judapies/Cabina-Flujo-Horizontal/2018/CFLH 120 Instruelectronic #004587854/SGC/FJP- 53 RECEPCION E INSPECCION DE PCB.docx

Fecha: | Referencia: | Modelo: | Orden de Pedido:

DESCRIPCIÓN DE LA MEDICIÓN | VALOR ESPERADO | VALOR OBTENIDO | OBSERVACIONES
Largo de PCB
Ancho de PCB
Pin 11 y Pin 12 U1 | Infinito
Pin 1 y Pin 2 LCD1 | Infinito
Tamaño Agujeros Sujeción | 5/32”
Pin 1 y Pin 2 J4 | Infinito
*Medición entre pines de Display | Infinito
Pin 1 y Pin 2 U7 | Infinito
Pin 1 y Pin 2 U5 | Infinito
Pin 1 y Pin 2 U4 | Infinito
Pin 3 y Pin 2 U4 | Infinito
Inspección Visual general de la PCB | N/A | N/A

OBSERVACIONES:____________________________________________________________________________________________________________________________________________________________________________________________________________________________________________________________________________________________________________________________________________________________________________________________

- Recuerde realizar las mediciones de acuerdo a la escala de la medida.
- Si fue necesario alguna corrección menciónela en la sección de observaciones y registre los valores medidos separados por un guion (-).

*Realizar la medición entre el pin 1 con todos los demás pines, de igual forma con los siguientes pines.

Realizo: | Revisó: | Aprobó:
Firma: | Firma: | Firma:
Cargo: | Cargo: | Cargo: Dirección Técnica
--------------------------------------------------- | --------------------------------------------------- | Estado de Calidad: Aprobado:_____ Rechazado:_____

JP BIOINGENIERIA S.A.S RECEPCIÓN E INSPECCIÓN DE PCB(BARE BOARD TEST) FJP – 53 Versión 01 Efectivo a partir de: Marzo 31 de 2018
