judapies/Cabina-Flujo-Horizontal/2016/Mini CFLH Cali/Materiales/Listado de Componentes Cabina de Flujo Laminar Horizontal.pdf

Cabina Flujo Vertical 110V
Descripción | Referencia
OptoTriac | MOC3031
Triac | BTA-16
Borneras | 2 Pines Verdes
| 3 Pines Verde
Conectores GP (con uñas) | 8 Pines
| 16 Pines
Fusible Corto | 500 mA maximo
Portafusible Aereo | Para fusible corto
Disipador | Mediano para 7805
Puente Rectificador | Redondo 1A
Regulador de Voltaje | LM7805
| LM7806
Reostato pequeño | 10K
Cristal de Cuarzo | 4MHz
Resistencias 1/4W | 10K
| 1K
| 330R
Resistencias de Presición | 1K
Condensador | 470uF/25V
| 10uF/16V
| 0.1uF Monolitico
| 22pF
| 0.1uF Tantalio superficial (CT1206 0.1UF35)
Display | 4X20
Transformador | 110V a 0-6-9V 450mA
Varistor | 20D241K
Microcontrolador | PIC 18F4550
Regleta Profesional | 40 pines
Poste plastico | Para sujecion de tarjeta
Tarjetas Electronicas | Control
Botones | Tipo huevo blanco
Sensor de Presión Diferencial | MPXV5400DP
Amplificador Operacional | LM324
Ingenieros Faiver H. Trujillo G | Juan David Piñeros E

Cantidad | Precio | Precio Total | Sitio de Compra | Dirección
6 | $ 2.552 | $ 15.312 Sigma Electronica Ltda | Av. Cra 24 No 61D-65
6 | $ 2.320 | $ 13.920 Sigma Electronica Ltda | Av. Cra 24 No 61D-65
1 | $ 350 | $ 350 Sanyvi Electronics | Cra 9 # 19-30 LOC:212
7 | $ 400 | $ 2.800 Sanyvi Electronics | Cra 9 # 19-30 LOC:212
1 | $ 400 | $ 400 Sanyvi Electronics | Cra 9 # 19-30 LOC:212
2 | $ 800 | $ 1.600 Sanyvi Electronics | Cra 9 # 19-30 LOC:212
1 | $ 100 | $ 100 Sanyvi Electronics | Cra 9 # 19-30 LOC:212
1 | $ 600 | $ 600 Sanyvi Electronics | Cra 9 # 19-30 LOC:212
1 | $ 2.000 | $ 2.000 Sanyvi Electronics | Cra 9 # 19-30 LOC:212
1 | $ 400 | $ 400 Sanyvi Electronics | Cra 9 # 19-30 LOC:212
1 | $ 550 | $ 550 Sanyvi Electronics | Cra 9 # 19-30 LOC:212
1 | $ 800 | $ 800 Sanyvi Electronics | Cra 9 # 19-30 LOC:212
1 | $ 300 | $ 300 Sanyvi Electronics | Cra 9 # 19-30 LOC:212
1 | $ 450 | $ 450 Sanyvi Electronics | Cra 9 # 19-30 LOC:212
6 | $ 10 | $ 60 Sanyvi Electronics | Cra 9 # 19-30 LOC:212
6 | $ 10 | $ 60 Sanyvi Electronics | Cra 9 # 19-30 LOC:212
6 | $ 10 | $ 60 Sanyvi Electronics | Cra 9 # 19-30 LOC:212
2 | $ 1.000 | $ 2.000 Electronica China | Calle 21 # 9-12
1 | $ 250 | $ 250 Sanyvi Electronics | Cra 9 # 19-30 LOC:212
3 | $ 150 | $ 450 Sanyvi Electronics | Cra 9 # 19-30 LOC:212
2 | $ 100 | $ 200 Sanyvi Electronics | Cra 9 # 19-30 LOC:212
2 | $ 100 | $ 200 Sanyvi Electronics | Cra 9 # 19-30 LOC:212
10 | $ 406 | $ 4.060 Sigma Electronica Ltda | Av. Cra 24 No 61D-65
1 | $ 25.000 | $ 25.000 Sanyvi Electronics | Cra 9 # 19-30 LOC:212
1 | $ 6.500 | $ 6.500 Sanyvi Electronics | Cra 9 # 19-30 LOC:212
2 | $ 2.000 | $ 4.000 Sanyvi Electronics | Cra 9 # 19-30 LOC:212
1 | $ 15.000 | $ 15.000 Sanyvi Electronics | Cra 9 # 19-30 LOC:212
3 | $ 1.200 | $ 3.600 Sanyvi Electronics | Cra 9 # 19-30 LOC:212
4 | $ 150 | $ 600 Sanyvi Electronics | Cra 9 # 19-30 LOC:212
1 | $ 17.000 | $ 17.000 Yahiko Electronica Ltda | Calle 20 # 8-89
4 | $ 1.800 | $ 7.200 ATM Store SAS | Cra 9 # 19-30 LOC: 117
1 | $ 46.400 | $ 46.400 Sigma Electronica Ltda | Av. Cra 24 No 61D-65
1 | $ 1.102 | $ 1.102 Sigma Electronica Ltda | Av. Cra 24 No 61D-65
$ 173.324 TOTAL

2014- Abr-15
