judapies/Cabina-Flujo-Horizontal/2016/CFLH 120 Alcaldia Guacheta #004587557/Materiales/Listado de Componentes Cabina de Flujo Laminar Horizontal.xlsx

Sheet: Parte Electronica 110V
 | Cabina Flujo Vertical 110V
 | Descripción | Referencia | Cantidad | Precio | Precio Total | Sitio de Compra | Dirección
 | OptoTriac | MOC3031 | 6 | $2552 | $15312 | Sigma Electronica Ltda | Av. Cra 24 No 61D-65
 | Triac | BTA-16 | 6 | $2320 | $13920 | Sigma Electronica Ltda | Av. Cra 24 No 61D-65
 | Borneras | 2 Pines Verdes | 1 | $350 | $350 | Sanyvi Electronics | Cra 9 # 19-30 LOC:212
 |  | 3 Pines Verde | 7 | $400 | $2800 | Sanyvi Electronics | Cra 9 # 19-30 LOC:212
 | Conectores GP (con uñas) | 8 Pines | 1 | $400 | $400 | Sanyvi Electronics | Cra 9 # 19-30 LOC:212
 |  | 16 Pines | 2 | $800 | $1600 | Sanyvi Electronics | Cra 9 # 19-30 LOC:212
 | Fusible Corto | 500 mA maximo | 1 | $100 | $100 | Sanyvi Electronics | Cra 9 # 19-30 LOC:212
 | Portafusible Aereo | Para fusible corto | 1 | $600 | $600 | Sanyvi Electronics | Cra 9 # 19-30 LOC:212
 | Disipador | Mediano para 7805 | 1 | $2000 | $2000 | Sanyvi Electronics | Cra 9 # 19-30 LOC:212
 | Puente Rectificador | Redondo 1A | 1 | $400 | $400 | Sanyvi Electronics | Cra 9 # 19-30 LOC:212
 | Regulador de Voltaje | LM7805 | 1 | $550 | $550 | Sanyvi Electronics | Cra 9 # 19-30 LOC:212
 |  | LM7806 | 1 | $800 | $800 | Sanyvi Electronics | Cra 9 # 19-30 LOC:212
 | Reostato pequeño | 10K | 1 | $300 | $300 | Sanyvi Electronics | Cra 9 # 19-30 LOC:212
 | Cristal de Cuarzo | 4MHz | 1 | $450 | $450 | Sanyvi Electronics | Cra 9 # 19-30 LOC:212
 | Resistencias 1/4W | 10K | 6 | $10 | $60 | Sanyvi Electronics | Cra 9 # 19-30 LOC:212
 |  | 1K | 6 | $10 | $60 | Sanyvi Electronics | Cra 9 # 19-30 LOC:212
 |  | 330R | 6 | $10 | $60 | Sanyvi Electronics | Cra 9 # 19-30 LOC:212
 | Resistencias de Presición | 1K | 2 | $1000 | $2000 | Electronica China | Calle 21 # 9-12
 | Condensador | 470uF/25V | 1 | $250 | $250 | Sanyvi Electronics | Cra 9 # 19-30 LOC:212
 |  | 10uF/16V | 3 | $150 | $450 | Sanyvi Electronics | Cra 9 # 19-30 LOC:212
 |  | 0.1uF Monolitico | 2 | $100 | $200 | Sanyvi Electronics | Cra 9 # 19-30 LOC:212
 |  | 22pF | 2 | $100 | $200 | Sanyvi Electronics | Cra 9 # 19-30 LOC:212
 |  | 0.1uF Tantalio superficial (CT1206 0.1UF35) | 10 | $406 | $4060 | Sigma Electronica Ltda | Av. Cra 24 No 61D-65
 | Display | 4X20 | 1 | $25000 | $25000 | Sanyvi Electronics | Cra 9 # 19-30 LOC:212
 | Transformador | 110V a 0-6-9V 450mA | 1 | $6500 | $6500 | Sanyvi Electronics | Cra 9 # 19-30 LOC:212
 | Varistor | 20D241K | 2 | $2000 | $4000 | Sanyvi Electronics | Cra 9 # 19-30 LOC:212
 | Microcontrolador | PIC 18F4550 | 1 | $15000 | $15000 | Sanyvi Electronics | Cra 9 # 19-30 LOC:212
 | Regleta Profesional | 40 pines | 3 | $1200 | $3600 | Sanyvi Electronics | Cra 9 # 19-30 LOC:212
 | Poste plastico | Para sujecion de tarjeta | 4 | $150 | $600 | Sanyvi Electronics | Cra 9 # 19-30 LOC:212
 | Tarjetas Electronicas | Control | 1 | $17000 | $17000 | Yahiko Electronica Ltda | Calle 20 # 8-89
 | Botones | Tipo huevo blanco | 4 | $1800 | $7200 | ATM Store SAS | Cra 9 # 19-30 LOC: 117
 | Sensor de Presión Diferencial | MPXV5400DP | 1 | $46400 | $46400 | Sigma Electronica Ltda | Av. Cra 24 No 61D-65
 | Amplificador Operacional | LM324 | 1 | $1102 | $1102 | Sigma Electronica Ltda | Av. Cra 24 No 61D-65
 |  |  |  |  | $173324 | TOTAL
Ingenieros | Faiver H. Trujillo G | Juan David Piñeros E | 2014- Abr-15

Sheet: Parte Electrica 110V
Cabina Flujo Horizontal 110V
Descripción | Referencia | Cantidad | Precio Unitario | Precio Total
Breaker CHINT 1 polo | 2A | 1 | $10000 | $10000
Interruptor de balancin redondo | 20mm Negro | 1 | $3000 | $3000
Regleta de polietileno | 30A | 1 | $4500 | $4500
Prensacable | PG11 | 4 | $800 | $3200
Cable Encauchetado Conalcables | 3X12 | 4 | $4500 | $18000
Clavija | 110V 15A Leviton | 1 | $6500 | $6500
Frenos | Para riel | 2 | $500 | $1000
 |  |  |  | $46200 | TOTAL

Sheet: Hoja1
 | Cabina Flujo Vertical 220V
 | Descripción | Referencia | Cantidad
 | OptoTriac | MOC3021 | 6
 | Triac | BT137 | 2
 |  | BTA-16 | 4
 | Borneras | 2 Pines Verdes | 7
 |  | 3 Pines Verde | 1
 | Conectores GP (con uñas) | 5 Pines | 1
 |  | 16 Pines | 2
 | Puente Rectificador | Redondo 1A | 1
 | Regulador de Voltaje | LM7805 | 1
 | Reostato | 10K | 1
 | Cristal de Cuarzo | 4MHz | 1
 | Resistencias 1/4W | 10K | 6
 |  | 1K | 6
 |  | 330R | 6
 | Condensador | 470uF/25V | 1
 |  | 10uF/16V | 3
 |  | 100nF (104) | 2
 |  | 22pF | 2
 | Display | 4X20 | 1
 | Microcontrolador | PIC 18F4550 | 1
 | Terminales | Según muestra | 8
 | Breaker CHINT 2 polos | 2A | 1
 | Breaker CHINT 1 polo | 10A | 1
 | Interruptor de balancin redondo | 20mm | 1
 | Toma doble blanca | Leviton | 1
 | Tapa de seguridad para toma doble | Plastica gris | 1
 | Regleta de polietileno | 15A | 1
 | Prensacable | PG11 | 4
 | Cable Encauchetado Conalcables | 4X12 | 3m
Ingenieros | Faiver H. Trujillo G | Juan David Piñeros E | 2014- Abr-15
