judapies/Cabina-Flujo-Horizontal/2018/CFLH 180 Flores de la Serena  #004587915/Materiales/Listado de Componentes Cabina de Bioseguridad.xlsx

Sheet: Parte Electronica 110V
Cabina Bioseguridad 110V
Descripción | Referencia | Cantidad | Sitio de Compra | Dirección
OptoTriac | MOC3041 | 4 | Sanyvi Electronics | Cra 9 # 19-30 LOC:212
Triac | BT-137 | 4 | Sanyvi Electronics | Cra 9 # 19-30 LOC:212
Borneras | 2 Pines Verdes | 12 | Sanyvi Electronics | Cra 9 # 19-30 LOC:212
Conectores GP (con uñas) | 8 Pines | 1 | Sanyvi Electronics | Cra 9 # 19-30 LOC:212
 | 3 Pines | 1 | Sanyvi Electronics | Cra 9 # 19-30 LOC:212
 | 2 Pines | 1 | Sanyvi Electronics | Cra 9 # 19-30 LOC:212
 | 4 Pines | 2 | Sanyvi Electronics | Cra 9 # 19-30 LOC:212
 | 16 Pines | 2 | Sanyvi Electronics | Cra 9 # 19-30 LOC:212
Disipador | Alto para 7805 | 1 | Sanyvi Electronics | Cra 9 # 19-30 LOC:212
Puente Rectificador | Redondo 1A | 1 | Sanyvi Electronics | Cra 9 # 19-30 LOC:212
Regulador de Voltaje | LM7805 | 1 | Sanyvi Electronics | Cra 9 # 19-30 LOC:212
Reostato pequeño | 10K | 1 | Sanyvi Electronics | Cra 9 # 19-30 LOC:212
Cristal de Cuarzo | 20MHz | 2 | Sanyvi Electronics | Cra 9 # 19-30 LOC:212
Resistencias 1/4W | 10K | 9 | Sanyvi Electronics | Cra 9 # 19-30 LOC:212
 | 1K | 7 | Sanyvi Electronics | Cra 9 # 19-30 LOC:212
 | 330R | 4 | Sanyvi Electronics | Cra 9 # 19-30 LOC:212
Condensador | 470uF/25V | 1 | Sanyvi Electronics | Cra 9 # 19-30 LOC:212
 | 10uF/16V | 1 | Sanyvi Electronics | Cra 9 # 19-30 LOC:212
 | 0.1uF Monolitico | 2 | Sanyvi Electronics | Cra 9 # 19-30 LOC:212
 | 15pF | 4 | Sanyvi Electronics | Cra 9 # 19-30 LOC:212
 | 0.1uF Tantalio superficial (CT1206 0.1UF35) | 10 | Sigma Electronica Ltda | Av. Cra 24 No 61D-65
Display Grafico Azul | 128X64 | 1 | Sigma Electronica Ltda | Av. Cra 24 No 61D-65
Fuente Conmutada | RS-15-12 | 1 | Sigma Electronica Ltda | Av. Cra 24 No 61D-65
Microcontrolador | PIC 18F4685 | 1 | Sanyvi Electronics | Cra 9 # 19-30 LOC:212
Regleta Profesional | 40 pines | 1 | Sanyvi Electronics | Cra 9 # 19-30 LOC:212
Poste plastico | Para sujecion de tarjeta | 4 | Sanyvi Electronics | Cra 9 # 19-30 LOC:212
Botones | Tipo huevo blanco | 4 | Sanyvi Electronics | Cra 9 # 19-30 LOC:212
Sensor de Presión Diferencial | MPXV5400DP | 2 | Sigma Electronica Ltda | Av. Cra 24 No 61D-65
Transistor | 2N3904 | 2 | Sanyvi Electronics | Cra 9 # 19-30 LOC:212
Diodo | 1N4004 | 2 | Sanyvi Electronics | Cra 9 # 19-30 LOC:212
Led | 5mm rojo | 1 | Sanyvi Electronics | Cra 9 # 19-30 LOC:212
Buzzer Redondo | Para Impreso 12V | 1 | Sanyvi Electronics | Cra 9 # 19-30 LOC:212
Conector Microfono | 2 Pines Metalico H-M | 5 | Sanyvi Electronics | Cra 9 # 19-30 LOC:212
 | 5 Pines Metalico H-M | 2 | Sanyvi Electronics | Cra 9 # 19-30 LOC:212
Pulsador | Normalmente Abierto negro | 1 | Sanyvi Electronics | Cra 9 # 19-30 LOC:212
Led | 5mm Rojo | 1 | Sanyvi Electronics | Cra 9 # 19-30 LOC:212
Interruptor magnetico | Blanco | 2 Parejas | Sanyvi Electronics | Cra 9 # 19-30 LOC:212
Interruptor redondo 20mm | ON-OFF Negro sin piloto | 1 | Sanyvi Electronics | Cra 9 # 19-30 LOC:212

Sheet: Parte Electrica 110V
Cabina Bioseguridad
Descripción | Referencia | Cantidad
Breaker CHINT 1 polo | 4A | 2
 | 10A | 1
Interruptor de balancin redondo | 20mm Negro | 1
Regleta de polietileno | 30A | 1
 | 5A | 2
Prensacable | PG11 | 4
 | PG13.5 | 4
Cable Encauchetado Centelsa | 3X12 | 5m
Clavija | 110V 15A Leviton | 1
Frenos | Para riel | 2
Contactor | Bobina 110V; 9A | 1
 | Bobina 110V; 18A | 1
Buzzer | 110V | 1

Sheet: Hoja1
 | Cabina Flujo Vertical 220V
 | Descripción | Referencia | Cantidad
 | OptoTriac | MOC3021 | 6
 | Triac | BT137 | 2
 |  | BTA-16 | 4
 | Borneras | 2 Pines Verdes | 7
 |  | 3 Pines Verde | 1
 | Conectores GP (con uñas) | 5 Pines | 1
 |  | 16 Pines | 2
 | Puente Rectificador | Redondo 1A | 1
 | Regulador de Voltaje | LM7805 | 1
 | Reostato | 10K | 1
 | Cristal de Cuarzo | 4MHz | 1
 | Resistencias 1/4W | 10K | 6
 |  | 1K | 6
 |  | 330R | 6
 | Condensador | 470uF/25V | 1
 |  | 10uF/16V | 3
 |  | 100nF (104) | 2
 |  | 22pF | 2
 | Display | 4X20 | 1
 | Microcontrolador | PIC 18F4550 | 1
 | Terminales | Según muestra | 8
 | Breaker CHINT 2 polos | 2A | 1
 | Breaker CHINT 1 polo | 10A | 1
 | Interruptor de balancin redondo | 20mm | 1
 | Toma doble blanca | Leviton | 1
 | Tapa de seguridad para toma doble | Plastica gris | 1
 | Regleta de polietileno | 15A | 1
 | Prensacable | PG11 | 4
 | Cable Encauchetado Conalcables | 4X12 | 3m
Ingenieros | Faiver H. Trujillo G | Juan David Piñeros E | 2014- Abr-15
