judapies/Cabina-Flujo-Horizontal/2019/CFLH 150 D4X20 San Pedro Valle #004588031 OP2019180/SGC/FJP- 35  REQUISICION DE MATERIALES CFLH-V LCD.xlsx

JP BIOINGENIERIA S.A.S |  |  | REQUISICION DE MATERIALES |  |  |  |  |  |  |  | FJP - 35
 |  |  |  |  |  |  |  |  |  |  | Version 01
Efectivo a partir de: 20 Dic 2017 |  |  |  |  |  | Documento de origen: DJP- 24 |  |  |  |  | Pág. 1 de 1
FECHA |  |  | 2019
PRODUCTO: | Cabina CFLH |  |  |  |  |  |  | Orden de Pedido No. |  |  | 2019180
 |  |  |  |  |  |  |  | Visita Técnica:
DESCRIPCION |  |  |  |  |  | Referencia |  |  | CANTIDAD REQUERIDA
Tarjeta de control |  |  |  |  |  | DIELEC-CFLH-V0016 |  |  | 1
Resistencias Montaje Superficial 0805 |  |  |  |  |  | 330Ω |  |  | 2
Resistencias Montaje Superficial 0805 |  |  |  |  |  | 10k |  |  | 6
Resistencias Montaje Superficial 0805 |  |  |  |  |  | 1k |  |  | 3
Resistencias (1W) |  |  |  |  |  | 15k |  |  | 2
Resistencias (1W) |  |  |  |  |  | 39Ω |  |  | 2
Resistencias (1W) |  |  |  |  |  | 360Ω |  |  | 2
Resistencias (1W) |  |  |  |  |  | 470Ω |  |  | 2
Condensador Electrolitico | Reóstato | Reóstato | Reóstato | Reóstato | Reóstato | 470uF/25V | 10K (pequeño) | 10K (pequeño) | 1 | 2 | 2 | 2
Condensador Electrolitico | Reóstato | Reóstato | Reóstato | Reóstato | Reóstato | 10uF/25V | 10K (pequeño) | 10K (pequeño) | 1 | 2 | 2 | 2
Condensador de Poliester | Reóstato | Reóstato | Reóstato | Reóstato | Reóstato | 103/600V | 10K (pequeño) | 10K (pequeño) | 2 | 2 | 2 | 2
Condensador de Poliester | Reóstato | Reóstato | Reóstato | Reóstato | Reóstato | 50nF/600V | 10K (pequeño) | 10K (pequeño) | 2 | 2 | 2 | 2
Condensador de tantalio SMD | Condensadores | Condensadores | Condensadores | Condensadores | Condensadores | 0,1uF | 10 µF @ 16V | 10 µF @ 16V | 2
Condensador Electrolitico SMD | Reóstato | Reóstato | Reóstato | Reóstato | Reóstato | 1uF/25V | 10K (pequeño) | 10K (pequeño) | 1 | 2 | 2 | 2
Condensador Ceramico | Condensadores | Condensadores | Condensadores | Condensadores | Condensadores | 22pF | 10 µF @ 16V | 10 µF @ 16V | 2
Cristal de Quarzo | Cristal | Cristal | Cristal | Cristal | Cristal | 4MHz | 4MHz | 4MHz | 1
Regleta Macho | Conector GP (Con uñas) | Conector GP (Con uñas) | Conector GP (Con uñas) | Conector GP (Con uñas) | Conector GP (Con uñas) | 1X40 | 2P | 2P | 1
Conector GP (Con uñas) | Conector GP (Con uñas) | Conector GP (Con uñas) | Conector GP (Con uñas) | Conector GP (Con uñas) | Conector GP (Con uñas) | 8P | 5P | 5P | 1
Regleta Hembra | Conector GP (Con uñas) | Conector GP (Con uñas) | Conector GP (Con uñas) | Conector GP (Con uñas) | Conector GP (Con uñas) | 1X40 | 5P | 5P | 1
Regleta profesional | Regleta profesional | Regleta profesional | Regleta profesional | Regleta profesional | Regleta profesional | 1X40 | 1X40 | 1X40 | 2
Optocoplador |  |  |  |  |  | MOC3021 |  |  | 2
Triac |  |  |  |  |  | BT139 |  |  | 2
Transistor Montaje Superficial |  |  |  |  |  | MMBT2222A |  |  | 1
Puente Rectificador Montaje Superficial |  |  |  |  |  | DF02S |  |  | 1
Fuente Conmutada para PCB | Puente Rectificador | Puente Rectificador | Puente Rectificador | Puente Rectificador | Puente Rectificador | HLK-PM05 | Redondo 1.5A | Redondo 1.5A | 1 | 2 | 2 | 2
Interruptor Redondo | Puente Rectificador | Puente Rectificador | Puente Rectificador | Puente Rectificador | Puente Rectificador | ON-OFF Negro | Redondo 1.5A | Redondo 1.5A | 1 | 2 | 2 | 2
Borneras | Bornera | Bornera | Bornera | Bornera | Bornera | 2 pines Verde | 2 pines Verde | 2 pines Verde | 6 | 2 | 2 | 2
Botones | Botones | Botones | Botones | Botones | Botones | Tipo huevo blanco | Tipo huevo blanco | Tipo huevo blanco | 4 | 6 | 6 | 6
Sensor de Presion | Botones | Botones | Botones | Botones | Botones | MPXV5004DP | Tipo huevo blanco | Tipo huevo blanco | 1 | 6 | 6 | 6
Buzzer | Buzzer | Buzzer | Buzzer | Buzzer | Buzzer | 5V ó 12V | 5V a 12V | 5V a 12V | 1 | 2 | 2 | 2
Diodo Montaje Superficial |  |  |  |  |  | FM4004 |  |  | 1
Led 0805 |  |  |  |  |  | Rojo o Verde o Azul |  |  | 1
Disipador con pines para soldar |  |  |  |  |  | Grande |  |  | 2
Reostato pequeño |  |  |  |  |  | 10k |  |  | 1
Portafusible para impreso |  |  |  |  |  | Con Tapa |  |  | 2
Fusible Corto |  |  |  |  |  | 4A |  |  | 2
Microcontrolador | Microcontrolador | Microcontrolador | Microcontrolador | Microcontrolador | Microcontrolador | PIC 18F4550 | PIC 18F4550 | PIC 18F4550 | 1 | 2 | 2 | 2
Display LCD | Microcontrolador | Microcontrolador | Microcontrolador | Microcontrolador | Microcontrolador | 4X20 Azul | PIC 18F4550 | PIC 18F4550 | 1 | 2 | 2 | 2
Switch Magnetico |  |  |  |  |  | Para posicion de Vidrio |  |  | 1
Iman para Switch Magnetico |  |  |  |  |  | Para posicion de Vidrio |  |  | 1
Optocoplador |  |  |  |  |  | PC817 |  |  | 1
Rele de Estado Solido para impreso |  |  |  |  |  | G3MB-202P |  |  | 2
Varistor |  |  |  |  |  | 20Dk241 |  |  | 1
Breaker unipolar CHINT 4A |  |  |  |  |  | 09606 |  |  | 1
Breaker unipolar CHINT 10A |  |  |  |  |  | 09610 |  |  | 1
Riel |  |  |  |  |  | Omega |  |  | 15cm
Frenos para riel omega |  |  |  |  |  |  |  |  | 2
Pasacable |  |  |  |  |  | PG11
Pasacable |  |  |  |  |  | PG13,5
Clavija Leviton Amarilla |  |  |  |  |  | 115VAC/15A |  |  | 1
Toma |  |  |  |  |  | Hidrobox |  |  | 1
Modulo |  |  |  |  |  | Hidrobox |  |  | 1
Terminal |  |  |  |  |  | Tipo Bala hembra (roja)
Terminal |  |  |  |  |  | Tipo Bala Macho(roja)
Terminal |  |  |  |  |  | Tipo Bala hembra (Azul)
Terminal |  |  |  |  |  | Tipo Bala Macho (Azul)
Terminal |  |  |  |  |  | Tipo ojo (Amarilla)
Terminal |  |  |  |  |  | Tipo Faston (Azul)
Bornera plastica |  |  |  |  |  | 15A
Luz led |  |  |  |  |  |  |  |  | 1
Luz UV Germicida |  |  |  |  |  | 30W |  |  | 1
Balastro Multivoltaje |  |  |  |  |  | 2X32W |  |  | 1
Cable (sensor flujo) |  |  |  |  |  | Blindado 6x22
Cable (sensor vidrio) |  |  |  |  |  | Blindado 6x22
Cable (Botones) |  |  |  |  |  | Blindado 8x22
Cable (toma) |  |  |  |  |  | Encauchetado 3x14
Cable (Alimentacion) |  |  |  |  |  | Encauchetado 3x14
Cable (Motores) |  |  |  |  |  | Encauchetado 3x18
Cable (Luz blanca) |  |  |  |  |  | Encauchetado 2x18
Cable (Luz UV) |  |  |  |  |  | Encauchetado 2x18
SOLICITADO POR: |  |  |  | ENTREGADO POR: |  |  |  | RECIBIDO POR:
