judapies/Cabina-Flujo-Horizontal/2019/CFLH 60 Asociados en Reproduccion Humana#004587947/SGC/FJP- 35  REQUISICION DE MATERIALES CABINA DE FLUJO HORIZONTAL GLCD.xlsx

JP BIOINGENIERIA S.A.S |  |  | REQUISICION DE MATERIALES |  |  |  |  |  |  |  | FJP - 35
 |  |  |  |  |  |  |  |  |  |  | Version 01
Efectivo a partir de: 20 Dic 2017 |  |  |  |  |  | Documento de origen: DJP- 24 |  |  |  |  | Pág. 1 de 1
FECHA | 14 | 3 | 2019
PRODUCTO: | CFLH 60 GLCD |  |  |  |  |  |  | Orden de Pedido No. |  |  | 201942
 |  |  |  |  |  |  |  | Visita Técnica:
DESCRIPCION |  |  |  |  |  | Referencia |  |  | CANTIDAD REQUERIDA
Tarjeta de control |  |  |  |  |  | CabinaBioseguridad |  |  | 1
Resistencia (1/4W) |  |  |  |  |  | 330Ω |  |  | 4
Resistencias (1/4W) |  |  |  |  |  | 10k |  |  | 8
Resistencias (1/4W) |  |  |  |  |  | 1k |  |  | 8
Resistencias (1W) |  |  |  |  |  | 1k |  |  | 1
Condensador de Poliester | Reóstato | Reóstato | Reóstato | Reóstato | Reóstato | 104/600V | 10K (pequeño) | 10K (pequeño) | 1 | 2 | 2 | 2
Condensador Electrolitico | Condensadores | Condensadores | Condensadores | Condensadores | Condensadores | 470 µF @ 16V | 470 µF @ 16V | 470 µF @ 16V | 1 | 2 | 2 | 2
Condensador Electrolitico | Condensadores | Condensadores | Condensadores | Condensadores | Condensadores | 10 µF @ 16V | 10 µF @ 16V | 10 µF @ 16V | 1
Condensador de tantalio SMD | Condensadores | Condensadores | Condensadores | Condensadores | Condensadores | 0,1uF | 10 µF @ 16V | 10 µF @ 16V | 3
Condensador Monolitico | Condensadores | Condensadores | Condensadores | Condensadores | Condensadores | 104 | 10 µF @ 16V | 10 µF @ 16V | 2
Condensador Ceramico | Condensadores | Condensadores | Condensadores | Condensadores | Condensadores | 22pF | 10 µF @ 16V | 10 µF @ 16V | 2
Cristal de Quarzo | Cristal | Cristal | Cristal | Cristal | Cristal | 20MHz | 4MHz | 4MHz | 1
Conector GP (Con uñas) | Conector GP (Con uñas) | Conector GP (Con uñas) | Conector GP (Con uñas) | Conector GP (Con uñas) | Conector GP (Con uñas) | 2P | 2P | 2P | 1
Conector GP (Con uñas) | Conector GP (Con uñas) | Conector GP (Con uñas) | Conector GP (Con uñas) | Conector GP (Con uñas) | Conector GP (Con uñas) | 8P | 5P | 5P | 1
Conector GP (Con uñas) | Conector GP (Con uñas) | Conector GP (Con uñas) | Conector GP (Con uñas) | Conector GP (Con uñas) | Conector GP (Con uñas) | 4P | 5P | 5P | 2
Conector GP (Con uñas) | Conector GP (Con uñas) | Conector GP (Con uñas) | Conector GP (Con uñas) | Conector GP (Con uñas) | Conector GP (Con uñas) | 16P | 5P | 5P | 2
Regleta profesional | Regleta profesional | Regleta profesional | Regleta profesional | Regleta profesional | Regleta profesional | 1X40 | 1X40 | 1X40 | 2
Optocoplador |  |  |  |  |  | MOC3041 |  |  | 4
Triac |  |  |  |  |  | BT137 |  |  | 4
Transistor |  |  |  |  |  | 2N3904 |  |  | 2
Puente Rectificador |  |  |  |  |  | Redondo 1.5A |  |  | 1
Regulador 5V | Regulador 5V | Regulador 5V | Regulador 5V | Regulador 5V | Regulador 5V | LM7805 | LM 7805 | LM 7805 | 1
Fuente Conmutada | Puente Rectificador | Puente Rectificador | Puente Rectificador | Puente Rectificador | Puente Rectificador | 12V - 1,3A RS-15-12 | Redondo 1.5A | Redondo 1.5A | 1 | 2 | 2 | 2
Interruptor Redondo | Puente Rectificador | Puente Rectificador | Puente Rectificador | Puente Rectificador | Puente Rectificador | ON-OFF Negro | Redondo 1.5A | Redondo 1.5A | 1 | 2 | 2 | 2
Borneras | Bornera | Bornera | Bornera | Bornera | Bornera | 2 pines Verde | 2 pines Verde | 2 pines Verde | 12 | 2 | 2 | 2
Botones | Botones | Botones | Botones | Botones | Botones | Tipo huevo blanco | Tipo huevo blanco | Tipo huevo blanco | 4 | 6 | 6 | 6
Buzzer | Buzzer | Buzzer | Buzzer | Buzzer | Buzzer | 5V ó 12V | 5V a 12V | 5V a 12V | 1 | 2 | 2 | 2
Diodo |  |  |  |  |  | 1N4004 |  |  | 1
Diodo led difuso |  |  |  |  |  | Rojo 5mm |  |  | 1
Disipador con pines para soldar |  |  |  |  |  | Mediano |  |  | 1
Reostato pequeño |  |  |  |  |  | 10k |  |  | 1
Sensor de presion |  |  |  |  |  | MPXV5004DP |  |  | 1
Microcontrolador | Microcontrolador | Microcontrolador | Microcontrolador | Microcontrolador | Microcontrolador | PIC 18F4685 | PIC 18F4550 | PIC 18F4550 | 1 | 2 | 2 | 2
Display GLCD | Microcontrolador | Microcontrolador | Microcontrolador | Microcontrolador | Microcontrolador | 128x64 px Azul | PIC 18F4550 | PIC 18F4550 | 1 | 2 | 2 | 2
Poste Plastico 18mm de altura |  |  |  |  |  | POSTE-18 (https://www.sigmaelectronica.net/producto/poste-18/) |  |  | 5
Breaker unipolar CHINT 10A |  |  |  |  |  | 09610 |  |  | 1
Riel |  |  |  |  |  | Omega
Frenos para riel omega |  |  |  |  |  |  |  |  | 2
Pasacable |  |  |  |  |  | PG11 |  |  | 5
Pasacable |  |  |  |  |  | PG13,5 |  |  | 2
Clavija Leviton Amarilla |  |  |  |  |  | 115VAC/15A |  |  | 1
Contactor CHINT 9A 110V |  |  |  |  |  | 00905 |  |  | 1
Balastro |  |  |  |  |  | 2X32W |  |  | 1
Caja de Paso Plastica |  |  |  |  |  | K2121-116 |  |  | 1
Luz LED Tipo Regleta |  |  |  |  |  | 60cm |  |  | 1
Interruptor de Codillo |  |  |  |  |  | 2 Posiciones |  |  | 1
Terminal |  |  |  |  |  | Tipo Bala hembra (roja)
Terminal |  |  |  |  |  | Tipo Bala Macho(roja)
Terminal |  |  |  |  |  | Tipo Bala hembra (Azul)
Terminal |  |  |  |  |  | Tipo Bala Macho (Azul)
Terminal |  |  |  |  |  | Tipo ojo (Amarilla)
Terminal |  |  |  |  |  | Tipo Faston (Azul)
Bornera plastica |  |  |  |  |  | 15A
Cable (Botones) |  |  |  |  |  | Blindado 8x22
Cable (Alimentacion) |  |  |  |  |  | Encauchetado 3x14
Cable (Motores) |  |  |  |  |  | Encauchetado 3x18
Cable (Luz blanca) |  |  |  |  |  | Encauchetado 2x18
Cable (Luz UV) |  |  |  |  |  | Encauchetado 2x18
SOLICITADO POR: |  |  |  | ENTREGADO POR: |  |  |  | RECIBIDO POR:
