judapies/Cabina-Flujo-Horizontal/2018/CFLH 120 Blamis Medidor de Flujo #004587820/Schematic con Seleccion de Velocidad/CabinaCFLH_SensorFlujo.DXF

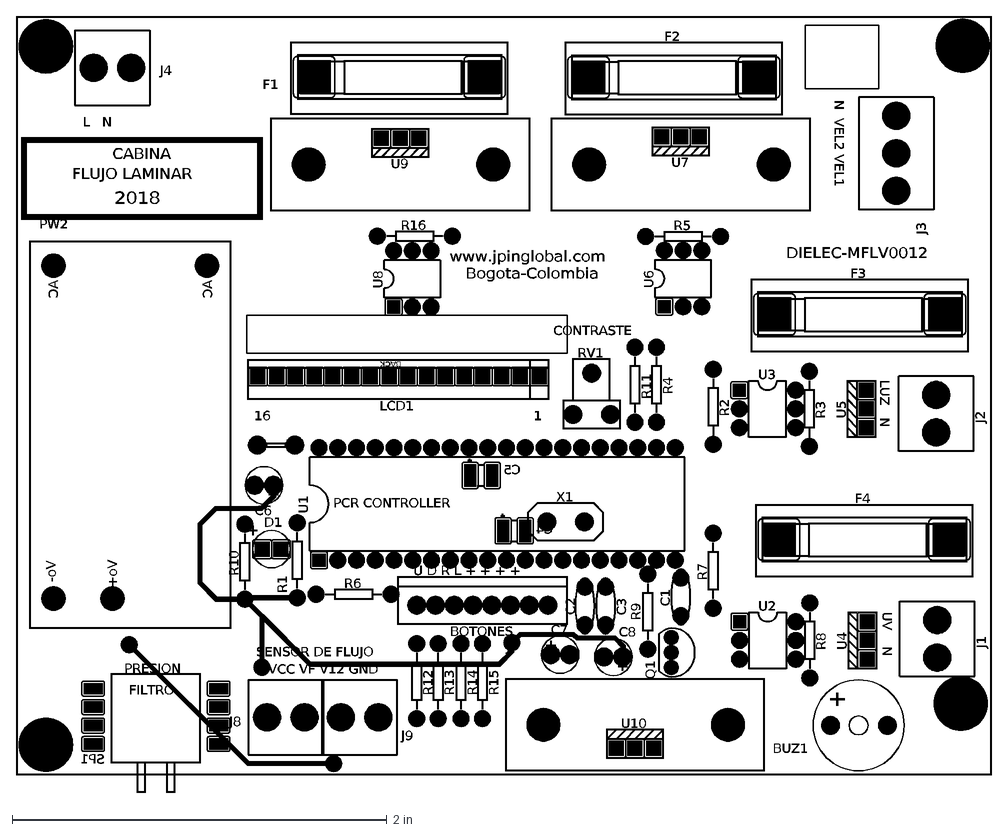
[picture p3: CAD file, 2021-07-15]
2018/CFLH 120 Blamis Medidor de Flujo #004587820/Schematic con Seleccion de Velocidad/CabinaCFLH_SensorFlujo.DXF
U1
J7
R12
R13
R14
R15
R6
SP1
R1
C1
BACK
LCD1
RV1
X1
C2
C3
J4
R7
R2
R3
R4
U2
U3
U6
R8
R5
U4
U5
U7
J1
J2
F1
CABINA
FLUJO LAMINAR
2018
C4
C5
C6
AC
Vo+
Vo-
PW2
PCR CONTROLLER
BOTONES
U D R L + + + +
PRESION
FILTRO
1
16
CONTRASTE
L N
N VEL2 VEL1
UV N
LUZ N
+
BUZ1
Q1
R9
D1
R10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
