judapies/Cabina-Flujo-Horizontal/2018/CFLH 180 Flores de la Serena  #004587915/Schematic/CabinaBioseguridad.DXF

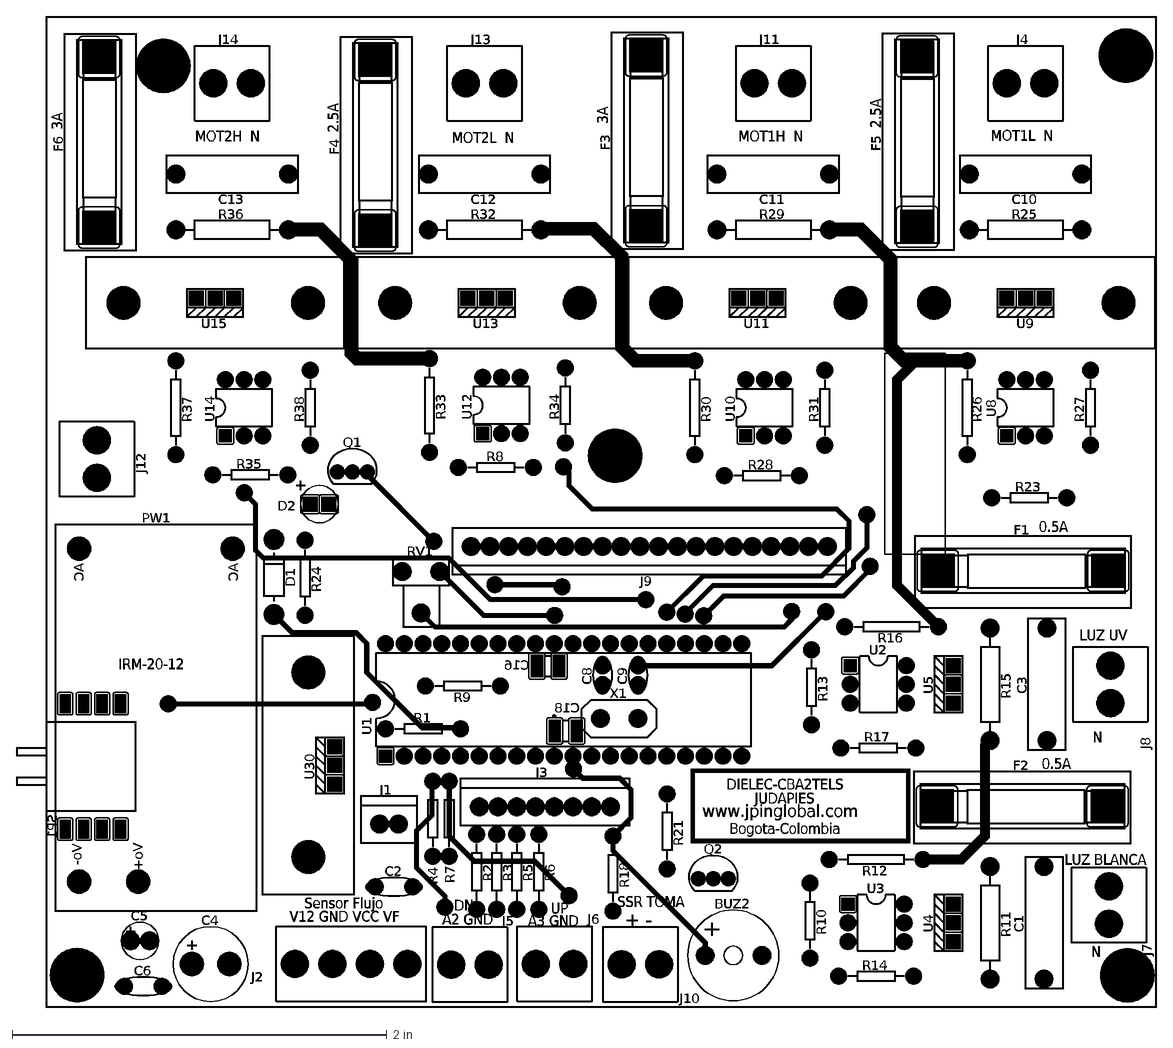
[picture p4: CAD file, 2021-07-15]
2018/CFLH 180 Flores de la Serena #004587915/Schematic/CabinaBioseguridad.DXF
U1
AC
Vo+
Vo-
PW1
C4
C5
C6
U30
D1
J2
J3
R2
R3
R4
R5
R6
R7
J5
J6
R24
D2
R18
J10
R21
Q2
+
BUZ2
J9
SP1
C2
J1
R1
R10
U3
R12
R14
U4
R11
C1
F2
J7
R13
U2
R16
R17
U5
R15
C3
J8
F1
R23
U8
R26
R27
U9
R25
C10
J4
F5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
