judapies/Cabina-Flujo-Horizontal/2019/CFLH 150 D4X20 San Pedro Valle #004588031 OP2019180/Schematic/User Library-LCD 4X20.IGS

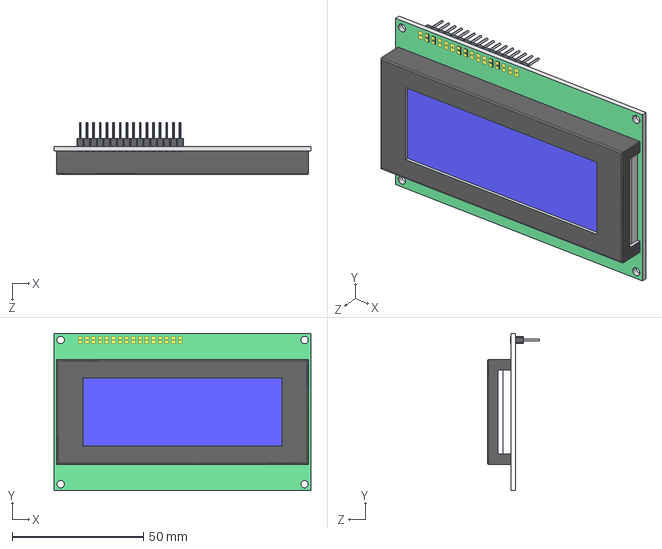
[picture p5: CAD file, 2021-07-15]
2019/CFLH 150 D4X20 San Pedro Valle #004588031 OP2019180/Schematic/User Library-LCD 4X20.IGS
98.0 x 60.0 x 20.0 mm
