judapies/Cabina-Flujo-Horizontal/2019/CFLH 60 TIM #004587995 OP2019135/Schematic/CabinaCFLH-V-D4X20.DXF

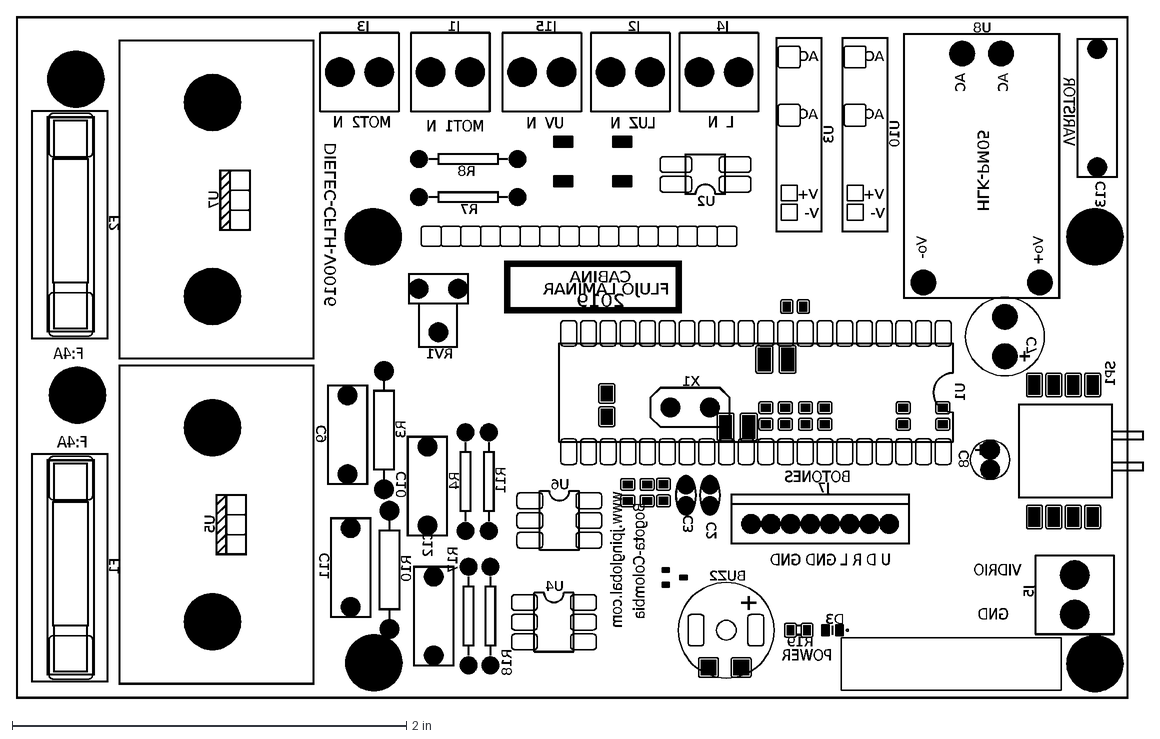
[picture p7: CAD file, 2021-07-15]
2019/CFLH 60 TIM #004587995 OP2019135/Schematic/CabinaCFLH-V-D4X20.DXF
CABINA
FLUJO LAMINAR
2019
Bogota-Colombia
www.jpinglobal.com
HLK-PM05
U1
SP1
D3
R19
C2
C3
X1
J5
J4
R7
R8
U2
U4
R17
R18
U5
C12
R10
C11
F1
U6
R4
R11
C10
R3
C9
U7
F2
J1
J3
J7
+
BUZ2
RV1
AC
V+
V-
U3
U10
Vo+
Vo-
U8
J2
J15
C13
C7
C8
L N
LUZ N
UV N
MOT1 N
MOT2 N
F:4A
VARISTOR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
