judapies/Cabina-Flujo-Horizontal/2019/CFLH 90 D4x20 Biomerk #004587991 OP2019126/Schematic con Seleccion de Velocidad/CabinaCFLH-V.DXF

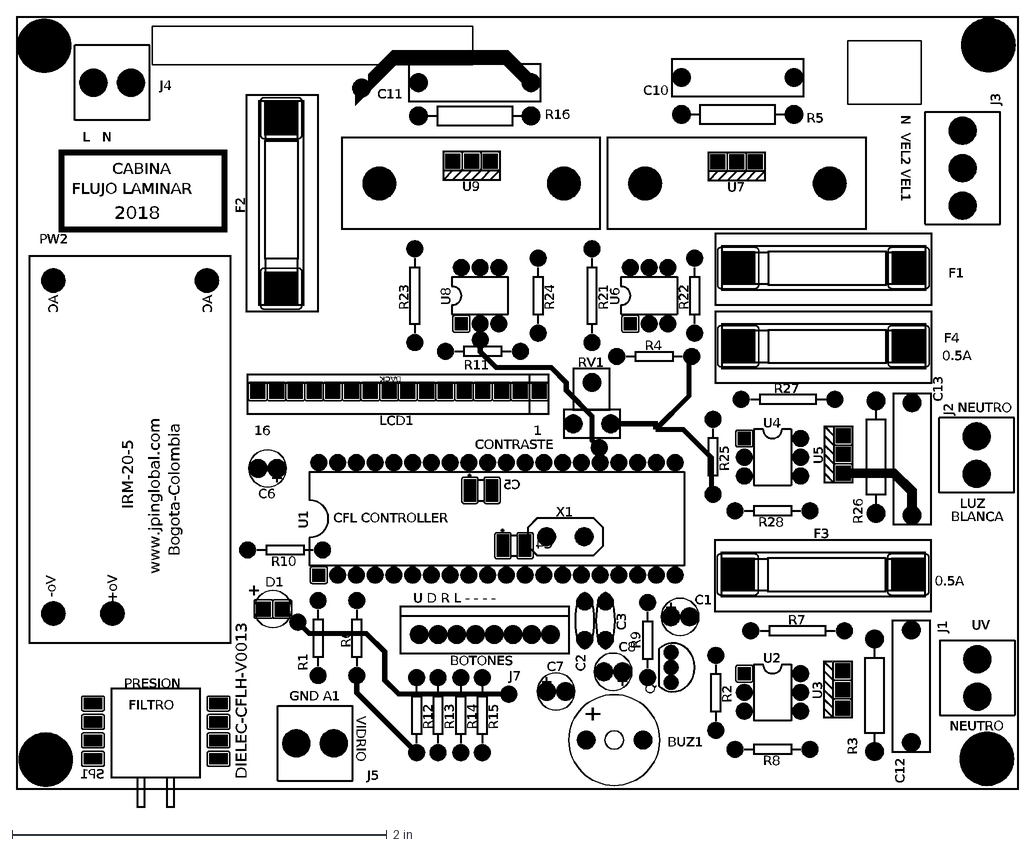
[picture p8: CAD file, 2021-07-15]
2019/CFLH 90 D4x20 Biomerk #004587991 OP2019126/Schematic con Seleccion de Velocidad/CabinaCFLH-V.DXF
U1
J7
R12
R13
R14
R15
R6
SP1
R1
C1
BACK
LCD1
RV1
X1
C2
C3
J4
R4
CABINA
FLUJO LAMINAR
2018
C4
C5
C6
AC
Vo+
Vo-
PW2
CFL CONTROLLER
BOTONES
U D R L - - - -
PRESION
FILTRO
1
16
CONTRASTE
L N
N VEL2 VEL1
Q1
R9
D1
R11
J3
DIELEC-CFLH-V0013
C7
C8
GND A1
VIDRIO
J5
+
BUZ1
R2
U2
R7
R8
U3
R3
C12
F3
J1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
