judapies/Cabina-Flujo-Horizontal/2020/CFLH 180 Flores de la Serena Medidor de Flujo #0045881XX OP202059/Schematic/CabinaBioseguridad-R.DXF

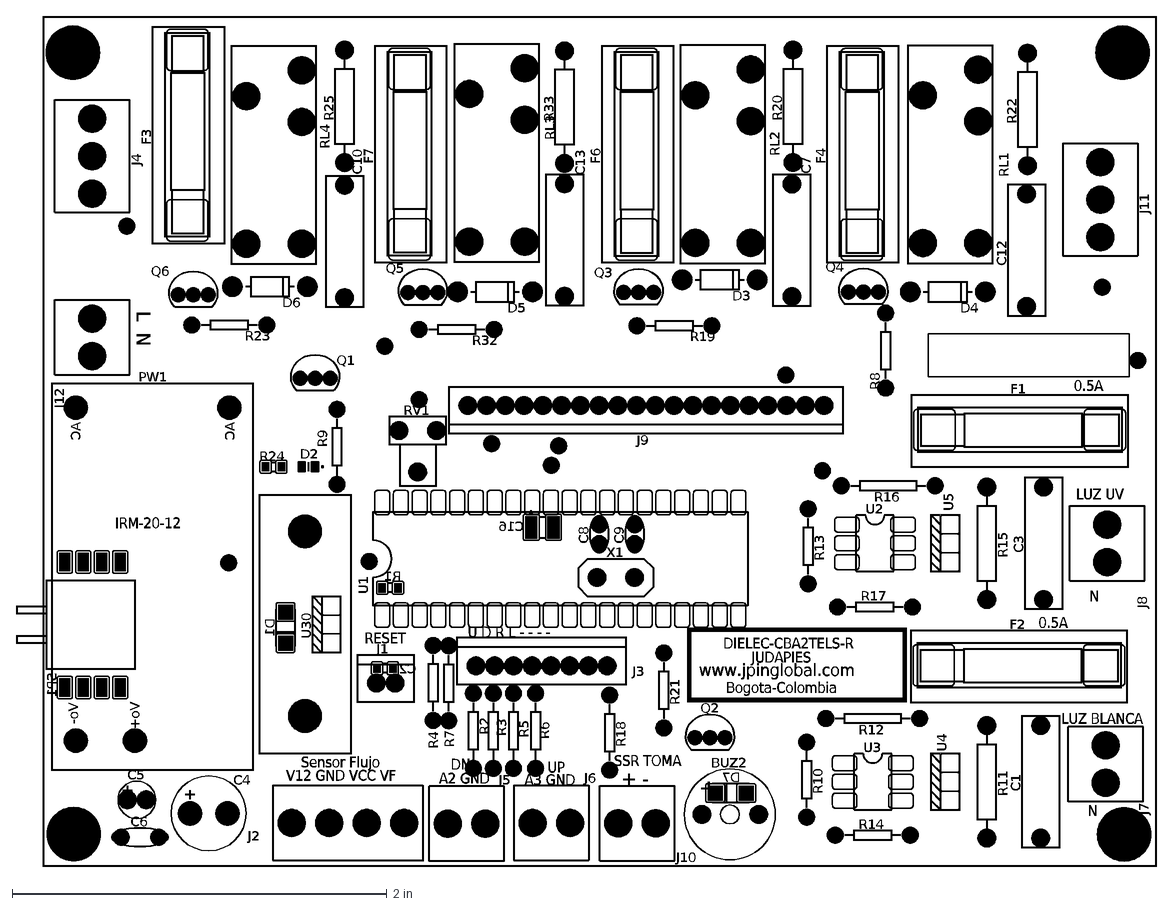
[picture p9: CAD file, 2021-07-15]
2020/CFLH 180 Flores de la Serena Medidor de Flujo #0045881XX OP202059/Schematic/CabinaBioseguridad-R.DXF
U1
AC
Vo+
Vo-
PW1
C4
C5
C6
U30
J2
J3
R2
R3
R4
R5
R6
R7
J5
J6
R18
J10
R21
Q2
+
BUZ2
J9
SP1
C2
J1
R1
R10
U3
R12
R14
U4
R11
C1
F2
J7
R13
U2
R16
R17
U5
R15
C3
J8
F1
X1
C8
C9
J12
Q1
R9
RV1
C16
V12 GND VCC VF
Sensor Flujo
DN
A2 GND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
