judapies/Cabina-Flujo-Horizontal/(list of files, cad)

Other CAD files:
2014/Cabina de Flujo Laminar Horizontal 120/Plano Electrico/Plano_Electrico_Cabina_Flujo_Vertical/Cabina_Flujo_Laminar_Vertical_JPCV36.dwg
2014/Mini Cabina/Plano Electrico/Mini-Cabina 110VAC/Distribucion de conexiones.dwg
2014/Mini Cabina/Plano Electrico/Plano_Electrico_Cabina_Flujo_Vertical/Distribución de Conexiones.dwg
2015/Mini Cabina/Plano Electrico/Mini-Cabina 110VAC/Distribucion de conexiones.dwg
2015/Mini Cabina/Plano Electrico/Plano_Electrico_Cabina_Flujo_Vertical/Distribución de Conexiones.dwg
2016/CFLH 120 Alcaldia Guacheta #004587557/Plano Electrico/Mini-Cabina 110VAC/Distribucion de conexiones.dwg
2016/CFLH 120 Alcaldia Guacheta #004587557/Plano Electrico/Plano_Electrico_Cabina_Flujo_Vertical/Conexiones de Panel de Control.dwg
2016/CFLH 120 Alcaldia Guacheta #004587562/Plano Electrico/Mini-Cabina 110VAC/Distribucion de conexiones.dwg
2016/CFLH 120 Alcaldia Guacheta #004587562/Plano Electrico/Plano_Electrico_Cabina_Flujo_Vertical/Distribución de Conexiones.dwg
2016/CFLH 120 Stock/Plano Electrico/Mini-Cabina 110VAC/Distribucion de conexiones.dwg
2016/CFLH 120 Stock/Plano Electrico/Plano_Electrico_Cabina_Flujo_Vertical/Cabina_Flujo_Laminar_Vertical_JPCV36.dwg
2016/CFLH 180 Chia/Plano Electrico/Mini-Cabina 110VAC/Distribucion de conexiones.dwg
2016/CFLH 180 Chia/Plano Electrico/Plano_Electrico_Cabina_Flujo_Vertical/Distribución de Conexiones.dwg
2016/CFLH 90 Caribean/Plano Electrico/Mini-Cabina 110VAC/Distribucion de conexiones.dwg
2016/CFLH 90 Caribean/Plano Electrico/Plano_Electrico_Cabina_Flujo_Vertical/Cabina_Flujo_Laminar_Vertical_JPCV36.dwg
2016/CFLH 90 Cecolfes/Plano Electrico/Mini-Cabina 110VAC/Distribucion de conexiones.dwg
2016/CFLH 90 Cecolfes/Plano Electrico/Plano_Electrico_Cabina_Flujo_Vertical/Conexiones de Luz Germicida y Luz Blanca.dwg
2016/CFLH 90 Grupo Digital Recovery/Plano Electrico/Mini-Cabina 110VAC/Distribucion de conexiones.dwg
2016/CFLH 90 Grupo Digital Recovery/Plano Electrico/Plano_Electrico_Cabina_Flujo_Vertical/Conexiones de Luz Germicida y Luz Blanca.dwg
2016/CFLH 90 Hospital Inmaculada/Plano Electrico/Mini-Cabina 110VAC/Distribucion de conexiones.dwg
2016/CFLH 90 Hospital Inmaculada/Plano Electrico/Plano_Electrico_Cabina_Flujo_Vertical/Cabina_Flujo_Laminar_Vertical_JPCV36.dwg
2016/CFLH 90 Medellin/Plano Electrico/Mini-Cabina 110VAC/Distribucion de conexiones.dwg
2016/CFLH 90 Medellin/Plano Electrico/Plano_Electrico_Cabina_Flujo_Vertical/Conexiones de Luz Germicida y Luz Blanca.dwg
2016/CFLH 90 REM Equipos/Plano Electrico/Mini-Cabina 110VAC/Distribucion de conexiones.dwg
2016/CFLH 90 REM Equipos/Plano Electrico/Plano_Electrico_Cabina_Flujo_Vertical/Conexiones de Panel de Control.dwg
2016/Mini CFLH Cali/Plano Electrico/Mini-Cabina 110VAC/Distribucion de conexiones.dwg
2016/Mini CFLH Cali/Plano Electrico/Plano_Electrico_Cabina_Flujo_Vertical/Cabina_Flujo_Laminar_Vertical_JPCV36.dwg
2016/Mini CFLH Heraz/Plano Electrico/Mini-Cabina 110VAC/Distribucion de conexiones.dwg
2016/Mini CFLH Heraz/Plano Electrico/Plano_Electrico_Cabina_Flujo_Vertical/Conexiones de Luz Germicida y Luz Blanca.dwg
2016/Mini CFLH Nutrizeta/Plano Electrico/Mini-Cabina 110VAC/Distribucion de conexiones.dwg
2016/Mini CFLH Nutrizeta/Plano Electrico/Plano_Electrico_Cabina_Flujo_Vertical/Distribución de Conexiones.dwg
2017/CFLH 120 #004587678 Lesco/Plano Electrico/Plano Electrico Cabina CFLH/ConexionesElectricasYElectronicas.dwg
2017/CFLH 120 Ecuador#004587636/Plano Electrico/Plano Electrico Cabina Flujo Laminar Horizontal/ConexionesElectricasYElectronicas.dwg
2017/CFLH 120 Especial #004587679/Plano Electrico/Plano Electrico Cabina CFLH/ConexionesElectricasYElectronicas.dwg
2017/CFLH 120 Especial #004587691/Plano Electrico/Plano Electrico Cabina CFLH/ConexionesElectricasYElectronicas.dwg
2017/CFLH 120 Setas #004587648/Plano Electrico/Plano Electrico Cabina Flujo Laminar Horizontal/ConexionesElectricasYElectronicas.dwg
2017/CFLH 120 Sincelejo #004587692/Plano Electrico/Plano Electrico Cabina CFLH/ConexionesElectricasYElectronicas.dwg
2017/CFLH 180 Universidad de Nariño/Plano Electrico/Plano Electrico Cabina Flujo Laminar Horizontal/ConexionesElectricasYElectronicas.dwg
2017/CFLH 60 #004587633/Plano Electrico/Plano Electrico Cabina Flujo Laminar Horizontal/ConexionesElectricasYElectronicas.dwg
2017/CFLH 60 #004587666 Stock/Plano Electrico/Plano Electrico Cabina CFLH/ConexionesElectricasYElectronicas.dwg
2017/CFLH 60 #004587667 Stock/Plano Electrico/Plano Electrico Cabina CFLH/ConexionesElectricasYElectronicas.dwg
2017/CFLH 90 #004587608/Plano Electrico/Plano Electrico Cabina Flujo Laminar Horizontal/ConexionesElectricasYElectronicas.dwg
2017/CFLH 90 #004587609/Plano Electrico/Plano Electrico Cabina Flujo Laminar Horizontal/ConexionesElectricasYElectronicas.dwg
2017/CFLH 90 Cartagena/Plano Electrico/Plano Electrico Cabina Flujo Laminar Horizontal/ConexionesElectricasYElectronicas.dwg
2017/CFLH 90 Monteria/Plano Electrico/Plano Electrico Cabina Flujo Laminar Horizontal/ConexionesElectricasYElectronicas.dwg
2017/CFLH 90 Panama #004587695/Plano Electrico/Plano Electrico Cabina CFLH/ConexionesElectricasYElectronicas.dwg
2017/CFLH 90 Panama #004587696/Plano Electrico/Plano Electrico Cabina CFLH/ConexionesElectricasYElectronicas.dwg
2017/CFLH 90 Panama #004587697/Plano Electrico/Plano Electrico Cabina CFLH/ConexionesElectricasYElectronicas.dwg
2017/CFLH 90 Stock #004587675/Plano Electrico/Plano Electrico Cabina Flujo Laminar Horizontal/ConexionesElectricasYElectronicas.dwg
2017/CFLH180 Cabina Flores La Serena #004587669/Plano Electrico CFLH Especial/Conexiones Caja Electrica.dwg
2018/CFLH 120 Blamis Medidor de Flujo #004587820/Plano Electrico/Plano Electrico Cabina CFLH/ConexionesElectricasYElectronicas.dwg
2018/CFLH 120 Instruelectronic #004587854/Plano Electrico/Plano Electrico Cabina CFLH/ConexionesElectricasYElectronicas.dwg
2018/CFLH 180 Flores de la Serena #004587915/PLANO ELECTRICO CFLH/Conexiones electricas y electronicas CFLH 180.dwg
2018/CFLH 180 Syngenta #004587843/Plano Electrico/Plano Electrico Cabina CFLH/ConexionesElectricasYElectronicas.dwg
2018/CFLH 60 #004587772/Plano Electrico/Plano Electrico Cabina CFLH/ConexionesElectricasYElectronicas.dwg
2018/CFLH 60 TIM #004587851/Plano Electrico/Plano Electrico Cabina CFLH/ConexionesElectricasYElectronicas.dwg
2018/CFLH 90 Avantika #004587848/Plano Electrico/Plano Electrico Cabina CFLH/ConexionesElectricasYElectronicas.dwg
2018/CFLH 90 Avantika #004587849/Plano Electrico/Plano Electrico Cabina CFLH/ConexionesElectricasYElectronicas.dwg
2018/CFLH 90 Avantika #004587850/Plano Electrico/Plano Electrico Cabina CFLH/ConexionesElectricasYElectronicas.dwg
2018/CFLH 90 Biohidroingenieria #004587789/Plano Electrico/Plano Electrico Cabina CFLH/ConexionesElectricasYElectronicas.dwg
2018/CFLH 90 Blamis #004587715/Plano Electrico/Plano Electrico Cabina CFLH/ConexionesElectricasYElectronicas.dwg
2018/CFLH 90 Blamis #004587771/Plano Electrico/Plano Electrico Cabina CFLH/ConexionesElectricasYElectronicas.dwg
2018/CFLH 90 Exportador #004587863/Plano Electrico/Plano Electrico Cabina CFLH/ConexionesElectricasYElectronicas.dwg
2018/CFLH 90 Laboratorio Clinico Especializado #004587908/Plano Electrico/Plano Electrico Cabina CFLH/ConexionesElectricasYElectronicas.dwg
2019/CFLH 120 Artilab #004587957/Plano Electrico/Plano Electrico Cabina CFLH/ConexionesElectricasYElectronicas.dwg
2019/CFLH 120 Clinica Colmena #004587975 OP201993/Plano Electrico/Plano Electrico Cabina CFLH/ConexionesElectricasYElectronicas.dwg
2019/CFLH 120 Ecuador Medidor de Flujo #004587951/PLANO ELECTRICO CFLH/Conexiones electricas y electronicas CFLH 180.dwg
2019/CFLH 150 D4X20 San Pedro Valle #004588031 OP2019180/Plano Electrico/Plano Electrico Cabina CFLH/ConexionesElectricasYElectronicas.dwg
2019/CFLH 60 Asociados en Reproduccion Humana#004587947/Plano Electrico/Plano Electrico Cabina CFLH/ConexionesElectricasYElectronicas.dwg
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
