judapies/Cabina-Flujo-Horizontal/CerificadoPruebasCFLH.docx

Informe de Funcionamiento

CABINA DE FLUJO LAMINAR VERTICAL

Información del Equipo

Equipo: _________________________________________ Modelo: ______________

Referencia: ______________________________________ Serie: ________________

Dimensiones Exteriores: ___________________________ Voltaje: _______________

Información equipo Patrón de medición de velocidad

Equipo: _________________________________________ Modelo: ____________

Referencia: ______________________________________ Serie: _______________

1. Pruebas de Funcionamiento
  1.1. Visualización Local de Humo

Ubique el equipo generador de humo en el área de trabajo de la cabina y verifique visualmente la dirección del flujo de aire en la cabina. Recuerde realizar este procedimiento con un elemento que proteja el área de trabajo con el fin de evitar daños a esta.

Resultado: ___________________________________________________________________________________________________________________________________________________________________________________________________________________________

  1.2. Medición de Velocidad de Aire.

Ubique el equipo patrón a pegado y a 4cm aproximadamente de la rejilla de salida de aire y en las posiciones que se observa en la Figura 1 y 2. Ingrese los datos de obtenidos de las mediciones en su respectivo espacio y determine el promedio de las mediciones.

Figura 1. Mediciones a 0cm de la rejilla de salida de aire

(X/4)*2

X/4

(Y/4)*2

Y/4

X

Y

Resultado: ___________________________________________________________________________________________________________________________________________________________________________________________________________________________

Figura 2. Mediciones a 4cm de la rejilla de salida de aire

(X/4)*2

X/4

(Y/4)*2

Y/4

X

Y

Resultado: ___________________________________________________________________________________________________________________________________________________________________________________________________________________________

  1.3. Sistema de Control

Verifique el sistema de control electrónico, realizando mediciones en los elementos descritos en la tabla 1. En caso de no tener valor de medición ingrese únicamente el estado del componente.

Tabla 1. Mediciones

Descripción | Valor Medido | Rango | Estado
Medición Voltaje de alimentación
Medición Voltaje Transformador
Medición Voltaje Alimentación DC
Voltaje DC Contraste Pantalla
Voltaje AC Luz blanca Activada
Voltaje AC Luz blanca desactivada
Voltaje AC Luz UV Activada
Voltaje AC Luz UV desactivada
Voltaje AC Motor Velocidad 1
Voltaje AC Motor Velocidad 2
Voltaje AC Motor Velocidad 3
Medición de temporizador UV
Valor de Presión con Motor ON
Valor de Presión con Motor OFF
Estado Teclado
Estado Display
Estado interruptor ON-OFF

2. Comentarios y anexos

_________________________________________________________________________

______________________________________________________________________________________________________________________________________________________________________________________________________________________________________________________________________________________________________________________________________________________________________________________________________________________________________________________

  2.1. Anexos (Espacio intencionalmente dejado en blanco)

Personas Encargadas del control de calidad.

Nombre: _________________________________________________________________

Cargo: ___________________________________________________________________

Profesión: ________________________________________________________________

Fecha: ___________________________________________________________________

Nombre: _________________________________________________________________

Cargo: ___________________________________________________________________

Profesión: ________________________________________________________________

Fecha: ___________________________________________________________________

Nombre: _________________________________________________________________

Cargo: ___________________________________________________________________

Profesión: ________________________________________________________________

Fecha: ___________________________________________________________________

www.jpinglobal.com mail comercial@jpinglobal.com Tel. (1) 7568668 Dir. Calle 80 número 69p07 Ferias Bogotá

JPBIOINGENIERIA S.A.S. NIT 900409216-6
