judapies/Cabina-Flujo-Horizontal/2018/CFLH 180 Flores de la Serena  #004587915/PLANO ELECTRICO CFLH/Conexiones electricas y electronicas CFLH 180.pdf

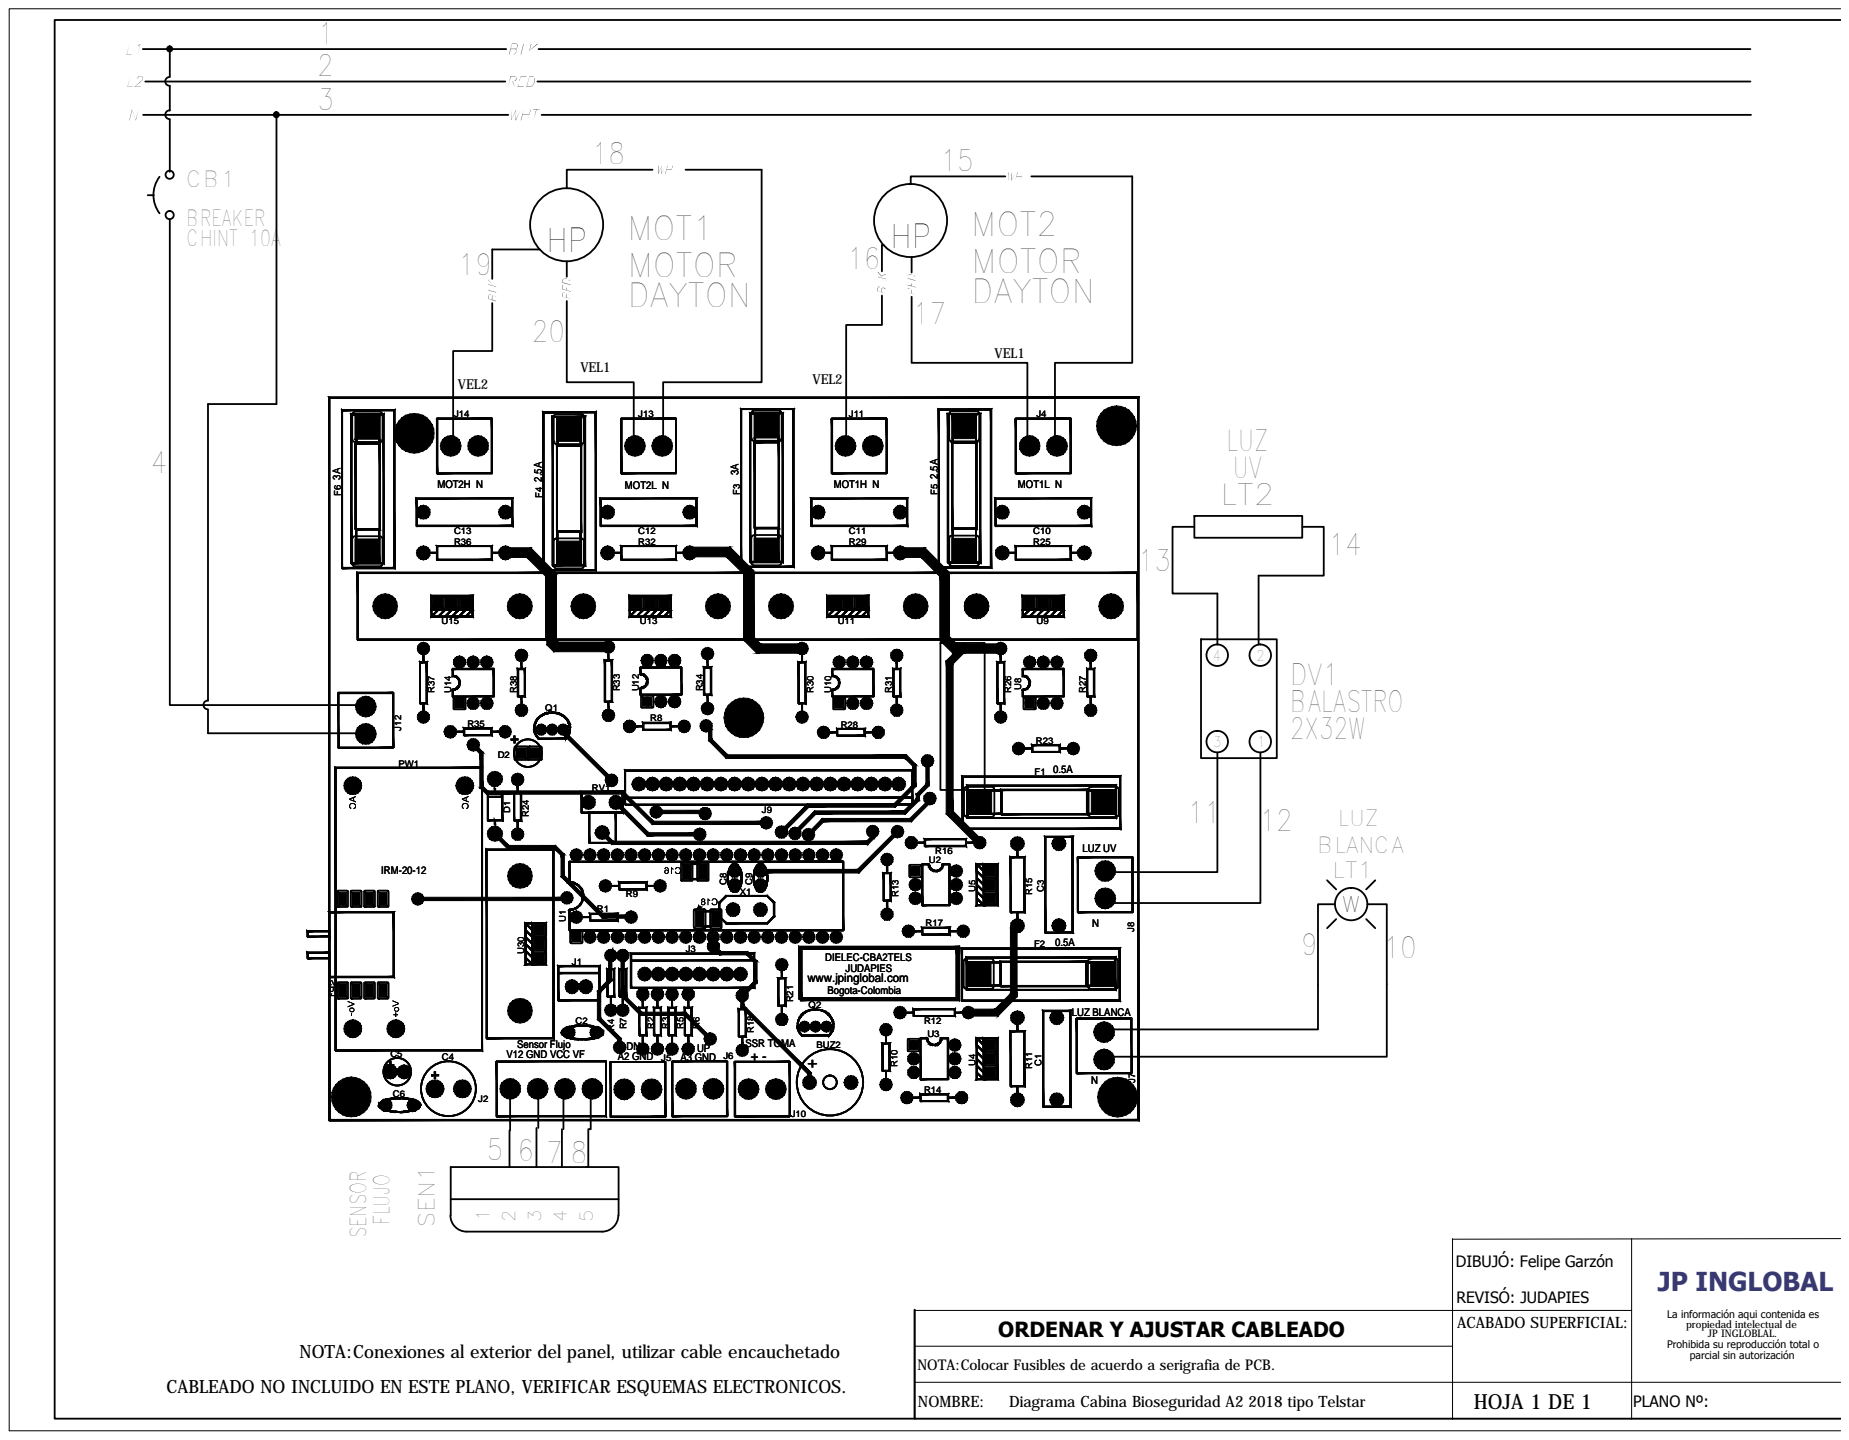
[picture p33: page 1]

FLUJO 12345 CABLEADO NO INCLUIDO EN ESTE PLANO, VERIFICAR ESQUEMAS ELECTRONICOS. NOTA:Conexiones al exterior del panel, utilizar cable encauchetado HP MOTOR DAYTON MOT1 HP MOTOR DAYTON MOT2 VEL2 VEL2 VEL1 VEL1 123 4 5 6 7 8 9 10 11 12 13 14 15 16 17 18 19 20

2.5A DIELEC-CBA2TELS JUDAPIES www.jpinglobal.com

J12 Q1 R9 RV1 V12 GND VCC VF Sensor Flujo DN A2 GND UP A3 GND SSR TOMA + - IRM-20-12 N LUZ BLANCA N LUZ UV 0.5A 0.5A MOT2H N MOT2L N MOT1H N MOT1L N
