judapies/Cabina-Flujo-Horizontal/(list of files, drawings)

Other design files:
2014/Cabina de Flujo Laminar Horizontal 120/Schematic/Cabina_Flujo_Vertical.DSN
2014/Cabina de Flujo Laminar Horizontal 120/Schematic/Cabina_Flujo_Vertical.LYT
2014/Mini Cabina/Schematic/Cabina_Flujo_Vertical.DSN
2014/Mini Cabina/Schematic/Cabina_Flujo_Vertical.LYT
2015/Mini Cabina/Schematic/Cabina_Flujo_Vertical.DSN
2015/Mini Cabina/Schematic/Cabina_Flujo_Vertical.LYT
2016/CFLH 90 Caribean/Schematic/Cabina_PCR.DSN
2016/CFLH 90 Caribean/Schematic/Cabina_PCR.LYT
2016/CFLH 90 Cecolfes/Schematic/Cabina_PCR.DSN
2016/CFLH 90 Cecolfes/Schematic/Cabina_PCR.LYT
2016/CFLH 90 Grupo Digital Recovery/Schematic/Cabina_PCR.DSN
2016/CFLH 90 Grupo Digital Recovery/Schematic/Cabina_PCR.LYT
2016/CFLH 90 Hospital Inmaculada/Schematic/Cabina_PCR.DSN
2016/CFLH 90 Hospital Inmaculada/Schematic/Cabina_PCR.LYT
2016/CFLH 90 Medellin/Schematic/Cabina_PCR.DSN
2016/CFLH 90 Medellin/Schematic/Cabina_PCR.LYT
2016/CFLH 90 REM Equipos/Schematic/Cabina_PCR.DSN
2016/CFLH 90 REM Equipos/Schematic/Cabina_PCR.LYT
2016/CFLH 120 Alcaldia Guacheta #004587557/Schematic/Cabina_PCR.DSN
2016/CFLH 120 Alcaldia Guacheta #004587557/Schematic/Cabina_PCR.LYT
2016/CFLH 120 Alcaldia Guacheta #004587562/Schematic/Cabina_PCR.DSN
2016/CFLH 120 Alcaldia Guacheta #004587562/Schematic/Cabina_PCR.LYT
2016/CFLH 120 Stock/Schematic/Cabina_PCR.DSN
2016/CFLH 120 Stock/Schematic/Cabina_PCR.LYT
2016/CFLH 180 Chia/Schematic/Cabina_PCR.DSN
2016/CFLH 180 Chia/Schematic/Cabina_PCR.LYT
2016/Mini CFLH Cali/Schematic/Cabina_PCR.DSN
2016/Mini CFLH Cali/Schematic/Cabina_PCR.LYT
2016/Mini CFLH Heraz/Schematic/Cabina_PCR.DSN
2016/Mini CFLH Heraz/Schematic/Cabina_PCR.LYT
2016/Mini CFLH Nutrizeta/Schematic/Cabina_PCR.DSN
2016/Mini CFLH Nutrizeta/Schematic/Cabina_PCR.LYT
2017/CFLH180 Cabina Flores La Serena #004587669/Schematic/CabinaBioseguridad.DSN
2017/CFLH180 Cabina Flores La Serena #004587669/Schematic/CabinaBioseguridad.LYT
2017/CFLH 60 #004587633/Schematic/Cabina_PCR.DSN
2017/CFLH 60 #004587633/Schematic/Cabina_PCR.LYT
2017/CFLH 60 #004587666 Stock/Schematic/Cabina_PCR.DSN
2017/CFLH 60 #004587666 Stock/Schematic/Cabina_PCR.LYT
2017/CFLH 60 #004587667 Stock/Schematic/Cabina_PCR.DSN
2017/CFLH 60 #004587667 Stock/Schematic/Cabina_PCR.LYT
2017/CFLH 90 #004587608/Schematic/Cabina_PCR.DSN
2017/CFLH 90 #004587608/Schematic/Cabina_PCR.LYT
2017/CFLH 90 #004587609/Schematic/Cabina_PCR.DSN
2017/CFLH 90 #004587609/Schematic/Cabina_PCR.LYT
2017/CFLH 90 Cartagena/Schematic/Cabina_PCR.DSN
2017/CFLH 90 Cartagena/Schematic/Cabina_PCR.LYT
2017/CFLH 90 Monteria/Schematic/Cabina_PCR.DSN
2017/CFLH 90 Monteria/Schematic/Cabina_PCR.LYT
2017/CFLH 90 Panama #004587695/Schematic/Cabina_PCR.DSN
2017/CFLH 90 Panama #004587695/Schematic/Cabina_PCR.LYT
2017/CFLH 90 Panama #004587696/Schematic/Cabina_PCR.DSN
2017/CFLH 90 Panama #004587696/Schematic/Cabina_PCR.LYT
2017/CFLH 90 Panama #004587697/Schematic/Cabina_PCR.DSN
2017/CFLH 90 Panama #004587697/Schematic/Cabina_PCR.LYT
2017/CFLH 90 Stock #004587675/Schematic/Cabina_PCR.DSN
2017/CFLH 90 Stock #004587675/Schematic/Cabina_PCR.LYT
2017/CFLH 120 #004587678 Lesco/Schematic/Cabina_PCR.DSN
2017/CFLH 120 #004587678 Lesco/Schematic/Cabina_PCR.LYT
2017/CFLH 120 Ecuador#004587636/Schematic/Cabina_PCR.DSN
2017/CFLH 120 Ecuador#004587636/Schematic/Cabina_PCR.LYT
2017/CFLH 120 Especial #004587679/Schematic/Cabina_PCR.DSN
2017/CFLH 120 Especial #004587679/Schematic/Cabina_PCR.LYT
2017/CFLH 120 Especial #004587691/Schematic/Cabina_PCR.DSN
2017/CFLH 120 Especial #004587691/Schematic/Cabina_PCR.LYT
2017/CFLH 120 Setas #004587648/Schematic/Cabina_PCR.DSN
2017/CFLH 120 Setas #004587648/Schematic/Cabina_PCR.LYT
2017/CFLH 120 Sincelejo #004587692/Schematic/Cabina_PCR.DSN
2017/CFLH 120 Sincelejo #004587692/Schematic/Cabina_PCR.LYT
2017/CFLH 180 Universidad de Nariño/Schematic/Cabina_PCR.DSN
2017/CFLH 180 Universidad de Nariño/Schematic/Cabina_PCR.LYT
2018/CFLH 60 #004587772/Schematic/Cabina_PCR.DSN
2018/CFLH 60 #004587772/Schematic/Cabina_PCR.LYT
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
